Ace6Rings/AUTONOMOUS-UWB-BOT/README.md

# AUTONOMOUS-UWB-BOT
A ground robot with four UWB anchors to determine its location via TDoA or ToF.
