Ace6Rings/AUTONOMOUS-UWB-BOT/JOURNAL.md

---
title: Autobot
author: Ace6Rings
description: placeholder
created_at: "8/2/2026"
---

# 8/7

This session is the first session for wiring the schematic.
I first spent some time researching the exact mcu and uwb chip I'm going to use for the anchors.
In my pitch, i already said that i am going to use the nrf 52840 and a dw3000 family chip. However, I looked for alternatives from the nrf 52840 because I didn’t want to deal with zephyr. I looked around the internet and found out that the nrf52840 have rust support and can deal with math really well.
The second thing is the package. I used the nrf 5340 qfaa before but it was a nightmare since it is impossible to use the inner ring of the chip without vippo. I did some research to pick the package for the nrf. I found out that the qfn package (48 pins) doesn’t support usb and have the high voltage pin shorted to the regular vdd pin, so using a dc dc thingy is impossible. This doesn’t really hurt the functionality but it does hurt power efficiency. But since the nrf is known for its power efficiency, it doesn’t really matter all that much (at least compared to an esp 32).

This research is around 30 minutes since i also skimmed through the datasheets of each alternate chip and compare the pros and cons. Said chip includes stuff like the esp32 c family and lower power stm 32.
Power delivery is very important in sensitive rf applications like this, so i took some extra care to find the best charging ic i can find. I found a really cool ic that just outputs a clean and regulated power.


It is the ic to the right. The BQ24075RGT is a cool power delivery manager that takes in usb power and charges the battery, and then does some cool internal stuff that outputs power. I skimmed through the datasheet and then finally completed the charging ic. It took around 1 hour to do these.
Now i needed to wire up the dw3210 and the nrf 52840 qfaa r7. It took a long time to get the footprints because all the ones i found are buns. 



You can tell how the symbol is really bad. The pins with multiple functions (like analog input, gpio, qspi) and stuff like that aren’t properly labled. They just put the number on there.
I tried to look for other symbols from other sites but they dont have this specific package available. In the end i have to make my own. I will probably change it soon so that when i wire it it will look good.


This is what i had by the end of remaking everything. This, along with finding all the junk, took around 45 minutes.

The dw3210 symbol took a while aswell. It turns out that only qorvo (afaik) have the symbols and i have been looking at the wrong sources the entire time. It looked something like this



I guess this one is a little better but everything is marked as passive so i have to change that soon. It appears that this is meant to replicate the actual footprint, so i guess its fine. Still lazy for not making this optimized for real world usage tho (like vss on the top).


This is what i had in the end. I spent around 45 minutes messing around with the power. I am worried that i will mess something up so i double and triple checked. I ended up using the reference design as of right now. But i will change it if i need to cuz of space constraints and whatnot. 
I took 45 minutes to look at the datasheet to know whats going on with the symbols you see on the left. The top left is just spi stuff but exton wake up and rstn was worth looking into. Exton i dont really know what to do yet since it lowk just pulls high when its doing stuff and pulls low when its not doing stuff. Ig i can link it to some gpio but its prolly useless.
Wake up is just waking up. Rstn is just reset, though i thought i needed pull up resistors but i realized since the nrf will be powered on in conjunction with the dw3210 anyway i might aswell just let the mcu take full control.
The middle left is just gpio stuff. For the netlabels not named as the gpio, i will use it as led indicators. You can see what it does by looking at the name. However, the gpios are hella butt because of this
0.8 mA does absolutely nothing. I guess i will use a cheap mosfet to drive the led ig, but thats if i have the space. Reading the dc characteristics of this took like 15 minutes to do.

Time spent: 4 hours

# 8/8 

I spent 30 minutes on fixing my schematic with my friend who knows how to route. 

I left sbu1 and 2 floating, added correct capacitor values to the charging ic, added correct capacitor values to the dw3210, fixed the rf configuration since 2pf cap not required for r2, fixed led direction, and a bunch of other stuff.

Time spent: 0.5 hours

# 8/9 

I finished the schematic for the anchor. 

The first thing I did was to optimize what pins i am going to use. I specifically made it so that the pins are divided into different functions and also the what side they are on in the physical footprint. I made the spi lines so that they wont have to do as much curves nor travel as long compared to if i just randomly picked it. 
On the left hand side of the schematic, I finished wiring all the decoupling capacitors, filters for the antenna and added LF filtering for the dc dc converter for better power efficiency. I confused reg0 and reg1, which is just the stages of power delivery in the nrf 52840, which made me think that dc dc is not available in this package. But it was, it was actually the LDO that was unavailable. 
I got a friend to double check my work and fixed my mistakes, i missed a capacitor for the antenna filtering and changed some values.



I made some connectors so that i can add additional sensors very easily when i build it in real life. Like a temperature or humidity sensor. There is no embedded sensors in this schematic. 
I will add gnd and 3v3 rails later.

I referenced the datasheet for the maximum values for ppm tolerance , ESR, load capacitance, and all the other specs. Then, i input the values that are valid in digikey and then i settled with these two crystals. One 32mhz one and the other 32.768 khz. They are pretty good, and since lower load capacitance can reduce start up time in the nrf, i got one with 8 pf. I would need to simulate the actual load capacitance since there will be some stray capacitance from the board, so i put in temporary values of 12 pf for each capacitor.

This is what it looked like in the end.

Next, I refined the dw3210/dw3220 part of the schematic. I added a crystal, dw gpios, and a second antenna. I want this project to support pdoa out of the box, so yeah. 

For this crystal, it is the recommended crystal to use according to the manufacturer of the dw3000 chips. So i just used that, same logic with the load capacitors. There is a 1 pf decoup cap for XTO.



This is what it looked like in the end.



I used a dip switch to do analog logic with how i am going to configure each anchor. The first switch will be if pdoa is on or off. If Switch 1 is on, pdoa is enabled, and vice versa.  It is connected to an adc/ain pin of the nrf. I did some research on how the ain pin of the nrf worked. It actually read voltage and had a really high input impedance of 5M, so i needed a 10k pull down resistor to complete the circuit and allow the ain pin to read the voltage. 
The next four switches is to identify the anchor. If pdoa is on, and all other switches are on, the anchor is a master, else, its a slave. Since there are four switches for ID, there is 2^4 amount of possibilities. This allows up to 16 anchors to be placed, which is wayyy more than enough. 


This is what the rest of the schematic look like.



This is the entire schematic.

Time spent: 5 hours
# 8/10
I moved on to the robot mainboard pcb today. First, I did a little bit of research on the general parts im going to use and I didn't really do much there.
The main thing I did today is wiring the power circuit. 
I am using the HUSB238 to negotiate the voltage the USBC will deliver, and I configured it so that it gave 12 volts 3 amps (or 3.5, i forgot).

I also added 22 ohm resistors to account for ringing, but it should probably be fine anyway since its usb 2.0
Then, I moved on to the battery charging IC. I chose the BQ24170RGYR. It is a pretty advanced battery charging ic since it can support up to 3 cells and have all those protections and stuff. But that also means there is alot of stuff to wire up. This took the majority of the session time since the documentation wasn't very good at all.

This is the final circuit (besides the values ofc) and it was pretty tedious to get to this point because of reference schematics like this.

It looks pretty simple after I made the circuit myself but it was a huge mess when I first saw it. 
There are pretty strange values like this

I guess they meant microfarad instead of millifarad since other reference circuits made it micro and it just doesnt make sense to have that big of a capacitor anyway.

Finally, I ended up with this LM5176 buck converter. This one is also pretty advanced since theres alot of protections and modes to change the frequency (ig noise) and stuff. This is useful when i make my own filtering later.
This will take some time because every capacitor value isn't fixed. I have to look at the datasheet and do some math to get the capacitor value i want since it does changes settings like bootup time and protection settings.

Time spent: 4.5 hours

# 8/13 

In this session, I worked on the rest of the power schematic for the main robot board.

I did some research on how to use this buck converter. Theres some features like dithering that I didn't need and some features like ccm that I do need for my usecase. I used the webench calculator to find the recommended values for the capacitors, inductors, and resistors for this ic so that I don't have to do the math. At the end, I ended up with the schematic you see above.
Then, I did some research for the rest of the power rails im going to have.
I decided that I should split the power from the battery (~12v) into 24v via the lm5175, and 5v via the LM2596. I didn't spend nearly as much time as with the other parts of the power schematic compared to this but I did do a little research on the efficiency curves. The lm2596 has around ~90% efficiency at 12 vin and 5 vout at like 1.5a or 2a. This is pretty much fine and its not like I'm powering anything crazy.

Then the 5 volts is going to go to components that need 5v (prolly or prolly not, depending on what stuff I put on there)
and then the 5v is going to go to different low noise ldo to 3v3. The dw3220 are each going to get their own ldo and their own filtering, and i'll make sure anti resonance doesnt happen (prolly won't anyway).


Time spent: 3 hours

# 8/15

Today is mainly figuring out the actual components of the board. As of right now, I'm going to use a stm32H7 series chip (footprint tbd), two bmi 270 so i can get accurate positioning and acceleration data, two dw 3220 for polling, two tmc 2209 la t for the motor drivers, four tof sensor modules (it will just little 2.54mm pins on the actual pcb since im going to use a module), and two rotary encoders.

I didn't get to record the entire session since it paused midway, but hopefully journaling is enough.



I first did the power for the stm32 and the boot pins and reset. I did some research and it turned out that most of the stuff i have to worry about is firmware, so yeah.



I then did some research on the bmi270 and decided to use the spi 4 wire option because it is faster than i2c. I have more than enough pins so it doesn't matter. They will both be in separate buses so that data arrives at the same time and i can average them out and stuff.



I read the datasheet for the tmc2209 and got to this. I had to make the symbol myself since the others were pretty bad.
I configured the tmc2209 so that it gives the stm32 data on the position of the motor via the index pin and also some other diagnostic stuff that i only have to worry about in the firmware. There are probably libraries already so im fine.
The diagnostic pin will give diagnostics ig and pdn uart is just a uart pin. Spread and stdby is marked nc because uart takes over anyway so its fine. MS2 and MS1 are configured in a way that it gives 64 microsteps and its uart id is 2. Usually its a problem if they have the same id but its fine because im using separate uart pins for each, so its all good. 
Now, all i have to do is place down some 2.54mm pins to connect my stuff to my modules. But this is going to be quite difficult on the pcb side since i have to account for the cad at the same time, and i dont even have a design in mind right now. The pcb shape will obviously need to account for the dw3220 antennas (2, or 4) so thats a significant amount of space. The mechanical side is not yet figured out exactly but i will just probably use a nema 14 and a timing belt at a 7.5 gear ratio to get the best torque i can. 
Im also not sure what to do about the power schematic so far since im afraid i will mess something up and the robot is gonna blow up.

Time spent: 2 hours

# 8/16

This session focuses on the digital part of the schematic. Usually I can just slap stuff onto the gpio and be done with it, but I've never used the stm32. 
First, I decided to switch my mcu to the stm32h743zit6 because of its higher clock speed (480 mhz). It does have a lower amount of ram (400kb less) but it should be fine since i won't be using a lidar.
Speaking of lidars, I decided to not use a 2d lidar anymore because the vehicle is going to be low on the ground. There is just no significant advantages to using a lidar over a ToF sensor. 
I chose to use the VL53L1X module from adafruit. I might use their other module with a smaller range in how much distance it measures but can measure shorter distances more accurately. I might just use that because this is meant for obstacle avoiding anyway.
(VL6180X)
Choosing the pins for the stm32 is also a challenge because of the board layout. The board will largely be symmetrical because i need it to be for my bmi 270 and dw3220. It just won't work correctly if it isn't. I did some preliminary wiring.

Oh yeah i changed the nreset wiring because it has an internal pull  up.

I made my own symbol for the adafruit module and it looks like that. I will organize my schematic later fr

After asking on the kicad discord server i decided that i shouldn't use an onboard battery charging module due to safety reasons. It won't improve my performance in anyway so i might aswell omit that and leave it for v2.

I added a ina226 to do some current sensing and added a shunt resistor. I might change the value but 5m seems good rn.

And yeah i changed the mcu to this



This is the entire schematic, i will clean it up later.
Time spent: 2 hours

# 8/19 

This session is about doing a little more research on how the overall project is going to go. First, I decided to look for simpler buck converters to avoid potential issues. I don't want by project to not work just because of some power management issue. However, all the simple buck converters can't provide sufficient power. 
So i decided to go back to the lm5175, mainly because i don't want my previous research and work to go to waste. After some thought, I decided that I should just make the power system on a separate breakout board.
The battery will first go to the breakout board via screw terminals (or whatever port is good, maybe i'll just get a 12v pack but thats chunky and looks unpolished). Then, the power will split to the lm5175 path and the other path will go straight to the 12v terminal. So one board provides both 12v and 24v. This is also optimal for noise because they are physically on separate boards.
I might also put the 5v buck converter here so that the board just outputs 24v and 5v. The 3v3 ldo will be on the mainboard to optimize for noise.

To do this, I first need to confirm my values and parts. So far, I've been slacking a little about part sourcing and values, but this time i need to confirm it.
The lm5175 will be configured for 12v-16v vin (originally 6-16v but 2.6uH inductors are very difficult to source, so 3.3uH is the best option), 24 vout, 10 ms wake up, and ccm on.
Because i changed the settings, the values naturally shift aswell.



You can see how the values changed and also my parts are there too (except for the mosfets, I will deal with them tomorrow).
Then, I moved onto some preliminary pcb routing. It is still unfinished and unpolished, but here is the progress i made.

I decided to use electrolytic capacitors (smd) because the datasheet says that its recommended.

I routed the config pins

The mosfets wont be sot23, so i didnt route this yet. The inductor is huge though.
Here is the overall board. It is going to be long and skinny. Hopefully this will turn out nicely. I doubt that the UWB performance will drop because of the extra wires, infact, it might be better since theres more space in the main board and less noise (hopefully). <br>

Time spent: 4.6 hours

# 8/20

This session is a continuation of making my breakout board for the power. 
Finding parts was quite a challenge because I am unfamiliar with analog and power circuits. I searched up what parts are recommended and i ended up using the reference parts from Webench calculator. Most of the parts are unavailable in jlcpcb pcba service, so i used the part as a reference instead. I finally got all my parts.



These are the parts i found, and of course i needed to source the footprints aswell. 
Overall, these didn't take so long. Maybe 1-1.5 hours worth of part sourcing.
The most challenging part was to find the correct inductor, since the rest of the bom depends on this one inductor. I configured the lm5175 so that it uses a 2.2uH inductor. Some inductors are just too big, and some aren't exactly power inductors. I finally found the correct inductor, and it is pretty space efficient too. 
This does mean i have to drop my max current but thats fine as long as i get nema 17 motors (8A max since 2 A per phase and there are 2 bipolar motors).
As for the capacitors, I've heard that polymer capacitors perform much better because of its ESR and ripple current. I don't know too deep about the capacitors, and power isn't the point of this project anyway. 
You might also notice that the picture of the lm5175 is a different package. That is because the qfn version is unavailable and I had to change the pin definitions. That was a little annoying but its fine. 
Now, for the PCB, I looked around the internet for recommended setups (cuz im not a professional). I tried out multiple orientations, but i find that this one works the best.

This one is pretty cool since all the high power stuff is in copper pours and the gate pins are conveniently placed. very cool. 

This part of the pcb wasn't in the previous picture because i didn't quite figure it out yet. I will probably place the diodes in a far away place since these diodes are just for boot pins.

I placed some vias for the SW1 and SW2 pins (sw2 not done). Hopefully that is enough to carry alot of current. The package of the lm5175 is certainly a challenge, and i am not sure of the effects of placing the hdrv1 trace so close, but it should be fine since it is only 300khz. They are separated by 2 layers anyway, with a gnd plane right underneath as reference. 
Also i might put the bottom stuff into the 3rd layer since that is what they are for anyway, power. 
I also need to figure out what to do with all the empty space, I can't exactly make it thinner or shorter, but functionally it should be ok for my robot. 

Time spent: 4.75 hours

# 8/21

I continued to route my pcb, it's almost done! I conferred with my friends, who also happens to be making a power supply using a buck boost converter, he gave me some tips like using a LTC2433 instead of using a current sense resistor for the average current sense feature. 
I also found some reference schematics at https://www.ti.com/reference-designs/index.html#search?keyword=LM5175 and https://www.ti.com/lit/df/tidrha4/tidrha4.pdf?ts=1787329435707&ref_url=https%3A%2F%2Fti.com%2F
I didn't really get anywhere far in this session since I was more focused on making my existing routing work and i was stressing over the placements of parts and such. I thought that I should place the decoupling capacitors close, but for this specific package it seems to be impossible.

This part of the pcb was what took most of the time today. There is just so much sensitive traces in a such weird order (cuz of the pinout) that it is pretty hard to make this work. Thankfully, I have reference pcbs to help me, but i shouldn't rely on that completely. 
I added this to my sw2 pin, technically i don't have to do this thick of a "trace" but it just looks so much nicer. I did some research on how this ic actually works, and it turns out that none of the pins actually have high current, they just sense stuff and switch the mosfets. 
Speaking of mosfets, this is the routing that i did. Its okay ig.

This is the entire pcb rn. I could just route the rest lazily and move along and it will still work (albeit prolly not well), but i want this to be as polished as it can be. 

Time spent: 2.5 hours

# 8/22 

For this session i finished the breakout board pcb routing and did half of the anchor pcb. 
For the breakout board i did some additional research on how to ground the thing and also the copper planes on the first layer.

To connect pgnd and agnd the datasheet says to connect them in the ic pad, which i did. There was some issues with getting the nets right.

From the two pictures, you can see that there is a small agnd plane and a bigger gnd plane for the rest of the bottom board. They are connected (will be after i get my via stitching plug in) using vias which stitches the 1st layer gnd plane to the 2nd layer gnd plane (unbroken). 

This is the final (not really) look of the pcb. There is definitely some improvements to be made but i want to focus on the real project instead of some power system. 
I planned to continue my mainboard schematic but decided that i should do the anchor pcb first, especially since the schematic is actually well polished and finished (except for some footprints).
I first used user drawings to draw out the shape of the pcb, this is 40mm by 75 mm. I centered everything using some user drawings aswell to make this as symmetrical as i can. This is because of the spi traces you see on the top of the nrf. 

You may also notice some pin header footprints on either side of the board. These are used to flash the chip, debug the chip, and also some extra gpio pins that i may or may not use after i build it (like adding a imu to detect if the anchor has been moved). In any case, these pin headers should be useful to me and also just makes the board much more useful for others to build off of. 
You may also notice that there are rounded traces for my rf trace. This is because im going to run this at ~8ghz but it can be like 7-9. I forgot the exact figures. There is also two dc blocker capacitors (0201) and im going to put a gnd plane on the first layer and stitch it. That way, everything should be ok. 

Time spent: 4.2 hours

# 8/23

For this session i continued working on the anchor pcb. Most of the time was spent trying to figure out how to do the decoupling capacitors for the dw3220. I can tell that i will spend quite some time to do the power system for the nrf52840 aswell. This is because i enabled the dc dc buck converter in the ic, which increases efficiency but adds a few components i need to use. Since i am aiming for having single side pcba, it is pretty difficult to optimize the placement. The crystal was a nuisance since it is big and also have external load capacitors. Conveniently, they are also next to the power pins i'm trying to decouple.

After a few tries, i think it turned out pretty good, i dont think i can optimize this further without changing the parts and footprints. Why not 0201? because that causes pcba to be much more expensive allegedly (didnt test).
I also used rounded corners to minimize reflection and stuff. The cyrstal is especially important, probably the most important component on the board besides the antennas. This is because i need precise clock measurements because of what i am doing with it (you should know from the context of this project).
According to the application notes, it seems to recommend a specific crystal and requests a 3.3 pf load capacitor. I will look more into it tomorrow. Also, there is stuff about band pass filters. I will look into that later aswell since it might be useful/required for the project. This could improve performance i guess.
But anyway, I didnt work on the actual rf portion of the pcb today. I did literally everything else except for the nrf antenna, i might not even use it but i guess i can give it a try (its just inconvenient to route)

So far, its looking good. 
I just need to find the inductors and dipswitch i want and everything will be complete. <br>
Time spent: 2.67 hours

# 8/24

I just added a dipswitch and a tactile switch to my pcb. Then, I added the inductor and capacitors. I will optimize for noise but right now i would like to focus on the actual rf portion of the pcb. I also noticed that the dw3220 is not available on jlcpcb nor digikey, so this could be an expensive project (i alr knew that anyway).
This time there isn't much to say since it really is just grunt work and the majority of the time spent is on part sourcing and footprint finding. 
Also i decided to not have a nrf52840 antenna since it is pretty useless and theres no space for it.

"

Time spent: 1.5 hours

# 8/25

This session focuses on the rf portion of the anchor. There isn't much routing going on today, I mainly did research on how the pcb itself is going to be manufactured and how that is going to affect my rf performance.
Different stackups have different effects on the antenna. I tried my best to follow the application notes for the dw3220, but due to manufacturing costs (some stackups can't be used with economic pcba) i am forced to use the normal/default stack up. I also decided that i want impedance control.

I also changed the material that the pcb is going to be made out of since it gives better performance ig. Its only a few extra dollars

I also chose to use epoxy via finish cuz i need it for via in pad (maybe)

I also did some research on how to route my antenna. This is preliminary since i didnt add my L1 gnd plane yet and the stitching vias are not confirmed yet cuz i need to do some calculations and such.

Time spent: 3 hours

# 8/26

I only did some preliminary research on how to do my pcb.
I made a plan to see what i am going to use for my mainboard, and after that research, things stayed mostly the same. I deleted the power stuff (the lm5175 and the husb238). That would simplify my design by a whole lot. 

I also changed the ms1 and ms2 config cuz it changes the uart address. The microstepping is done digitally instead of using ms1 and ms2 as a way to assign the uart address. I will likely use two buses so it doesnt rlly matter.
Other than that, nothing really happened on the schematic.

Time spent: 1.6 hours

# 8/27 and 8/29

I merged these two dates because it feels right to combine them cuz they basically do the same thingy ig.

I first did some research on esd protection. I will watch some videos on more protection circuits like an e fuse or whatever.
I did a placeholder esd protection thingy for my amt 102 and my usbc data lines (i prolly dont even need this cuz its not that deep).
As you can see, i didnt source all the parts yet cuz no one wants to find ferrite beads.
Then, I changed my lm2596 to the superior lmr51430 cuz its allegedly lower emi. I don't want to do that deep of research on analog/power circuits again. 

Doing the footprints also took a substantial amount of time. But it isnt anything crazy since i already know what components to use, unlike for the breakout board i made.
I didn't put the buck converter on the breakout board because there isn't enough space, and since its supposedly low emi i guess its fine if i put it far far away with some via stitiching. 
I think now is the best to start my pcb 

I did some prelim wiring. I like to do my components independently before slapping on the board because the routing is going to be the same anyway (like passives and stuff). The tmc 2209 shouldn't be hard at all to route. 

There isn't really much to say for this journal since there isn't much research, its all doing stuff i already knew.
But i will be reading alot of the stm32 documentation tomorrow since i want to make sure my stuff actually boots and also what all the pins do before doing more wiring. 

Time spent: 4.5 hours

# 9/2

In this session I worked on the power and boot logic for the stm32. 

I found out that i need a 10k resistor pulling it down instead of having it on the 3v3 side. 
I want my stm32 to boot in as many ways as possible, so i also added a connector thingy that a st-link v2 can directly connect to. 
I looked in my schematic and i found it to be messy and unorganized. So, i made a new schematic.






This took majority of the time.
I also took some time to look at the stm32 datasheet to figure out what pins to use. I only gotten a little bit of work done on the pcb side.


Figuring out what pins to use would be difficult because every single pin are multi function, so i need to choose my pins carefully. Some pins are also superior to others like one pin could have tim channel 1, which is the super accurate timer ig. I also need to make this board symmetrical and stuff.
I used the cubemx thingy to help me find the pins i need.
There isn't really anything else to say cuz its just grunt work atp.
Time spent: 4.75 hours

# 9/3

Today i did some preliminary routing for the motor driver and dw3220. 
I decided not to use two dw3220 since there is no real benefit to me and its also cheaper to just have one. It is also simpler mechanically too.
Routing the tmc2209 and the amt102 is a bit of a challenge because the stm32 has alot of bullshit pins that does alot of different things. 
I decided to use a timer pin for the step (to time it better ig) and use a special timer (tim1-8) for the amt102 because it can calculate whatever the amt102 sends back through hardware instead of me doing it by software (which is better). 



Right now, the board is a bit big, i will optimize for space later on and make it look cooler.
Time spent: 3.6 hours

# 9/4
I did some more research on how my mainboard should be. I decided that i should use a bldc instead of a stepper motor because it is more efficient, smaller, and lighter than a typical stepper motor. 
I didn't decide on the actual motor yet, but i did decide on the esc components.
I will be using the stm32g0 and the mct8316zr. I chose these two components because the stm32g0 is cheap and is more than capable of running the mct8316. Its job is just to tell the mct8316 what to do. It doesnt actually do any of the math. The math and other calculations (from the bmi270, dw3220, the tof sensor) will be done on the h743 because it has a fpu and has a higher clock rate (also more ram).
I chose the mct8316 because everything is integrated, so im not really making my own esc, but ig it is still a motor driver. The esc is not the point of the project so why bother making one myself when its specs are perfectly fine. 

Time spent: 2.52 hours

# 9/13
I decided on using two boards.
I will be using the stm32g0 (48 pin variant) because it is suitable for driving two mct8316zr and also the amt102.
I put the amt102 on the driver board so that it can correct any deviations from the commanded movement. For example,
the stm32h743 will tell the stm32g0 to move 10 meters forward, and then the g0 will generate a pwm signal to drive the motor until it reaches 10 meters. Without the amt, it could guess when it moves 10 meters, but it couldn't know for sure. But with the amt102, the stm32g0 will know for sure (not really but yk) that it did move 10 meters.
if i put it on the main board, then it is kinda bad because the stm32h743 will have to tell the driver board if its there or not. I want the motor movement to be independent after the h743 commands it to do something. 

This is the completed schematic for the driver board. 
The hierarchal sheets aren't done yet (the connectors), but it is just jst and banana plugs with esd protection (maybe), so it doesn't matter for now.
This design follows this logic:
the ToF sensors, bmi270, and the dw3220 will be on the main board. It will get its global coordinate from the dw3220 and get its local coordinate (not really? but yk its local) from the bmi 270 and the amt102 data. 
The mainboard will detect obstacles and its coordinates to determine movement. Once it does the math it will tell the stm32g0 via usart to move somewhere, this shouldn't take alot of bandwidth so thats why im using usart.
This sounds simple but the uwb part (lowk the entire point of the project) would be pretty hard to do, especially if i want to test nlos condiditons and ground that isn't completely flat (3d instead of 2d).

Time spent: 2.8 hours

# 9/14

I "finished" my schematic for my stm32g0 board. 

I moved onto making the pcb (i will add the passive footprints later). Unfortunately, i can't just mix and match the spi buses and i ended up with routing like this.

It took me a while to look for different orientations and ways of routing so that it isnt completely ass.
But other than that there isn't much else to say.

Time spent: 1.1 hours

# 10/3
I switched out the esc ic im going to use. I won't be using hall sensors in my motors, so i decided to go for a sensorless esc, the mct8316a1v. 


As you can see, the schematic is much simpler.

I had to make the symbol and figure out what pins to use, etc. I finished the schematic (well ig, there will be more polishing to do).
There isn't much else to say since this is really just grunt work, but there is lapse so wtv. 

Time spent: 4.25 hours

# 10/4
I finished the preliminary design of the driver board today. I first had to put the net labels onto the stm32 and then switch them around according to the physical footprint of the stm and mct. That didn't take very long and it worked out pretty well.
I tried to make the board smaller cuz smaller is better when i have limited space, and yeah.

I don't have the motor pad yet, but i will add them soon. It shouldn't take very long.
This is the top layer, it looks pretty good to me, but i will polish it towards the end of the project.
This is the bottom layer, theres nothing special. You might think why i used the back side for 5v and 3v3. Thats because if i were to use the 3rd layer, the power plane will be split (not really but like the path will be way longer. I also fixed up some vias so it doesnt cut the gnd plane too.

Time spent: 2.9 hours
# 10/10 

I finished the motor driver board (not polished)


this should functionally work, i made some changes to how i will connect everything.
i made almost everything (digital) jst cuz its easy to connect and impossible to physically connect it wrong. I also added esd protection on the two amt102, added a tvs to the 24v rail, and other stuff.
Im a little worried about the grounding, but it should be fine.




the routing looks okay, it could be better but that would just be more aesthetics than function.

I then ported the anchor pcb design to the mainboard because they use the same uwb chip (obviously) and the routing would be the same. 


Notice how there is no routing for the antenna yet, that is because i need to figure out the physical board config first and put it all in a calculator. I also plan on just using 0402 dc blocker capacitors because its cheaper for pcba. But that may do bad things to the signal, but then its impossible to make everything ideal anyway. 

time spent: 3.25 hours

# 10/11

I did some routing for the bmi270 and some research about the mechanics of the board. I didn't consider that having two imus might be useless if their physical conditions/environment is the same. So i need to think about separating the imus and/or putting little slots in the pcb.
I will also fix the power situation for the driver board later because putting power plane(s)/trace(s) near clock lines is pretty bad. 




The rest of the routing is going to be relatively easy since all the hard stuff is already done (not really). 

time spent: 1.9 hours

# 10/24

I routed the mainboard and changed how the ToF sensors are going to be configured. I will just put them all on one i2c bus, and change their addresses by using the xshut pin and change their addresses one at a time at start up. I also did the buttons, power, change the crystal routing, and some other stuff. 
As for the driver board, i changed the power routing.

The electronics are almost done. The cad should be much quicker since it wouldn't be much different to the other stuff i built.
the coding will be the most interesting part tho.

time spent: 3 hours

# 10/31

More routing. I changed the buck converter to a fixed one, which makes my life easier. There isn't much to say design wise, since this is just boring stuff. 
The routing looks pretty lame (prolly because it is), but it will work pretty well. I will fence the area near the bmi270 though.

Some power routing, I changed the terminal to smth bigger. I also added a switch ic so that it doesnt fry my shit.



Last things to do is wire the tof sensors, impedance match the antennas, and make it polished. Then check over it.

time spent: 2.4 hours
