Ace6Rings/AUTONOMOUS-UWB-BOT/ELECTRONICS/MAINBOARD/autobot_mainboard.kicad_pcb

## KiCad design ELECTRONICS/MAINBOARD/autobot_mainboard.kicad_pcb (2026-11-01)

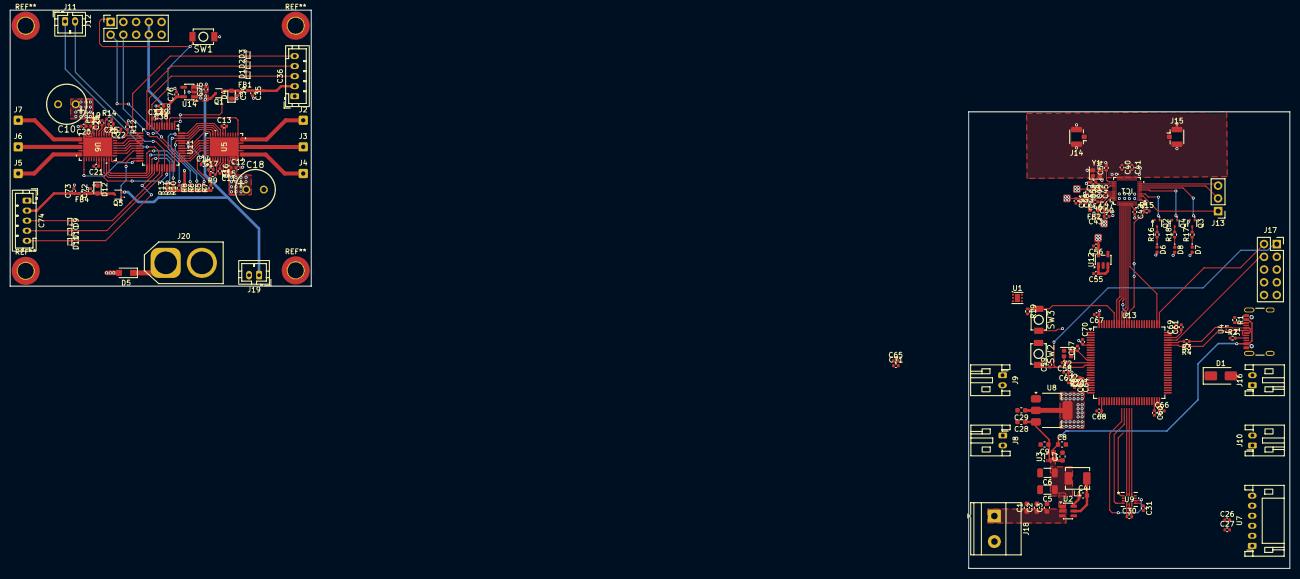
[picture p1: board autobot_mainboard.kicad_pcb from above]

Board: 4 copper layers, 255.0 x 111.2 mm, 156 parts (0 on the bottom side), 122 nets.

Parts:
C1, C28, C29: 10u; C_0603_1608Metric
C2: 1u; C_0603_1608Metric
C3, C4, C7, C8: 100n; C_0603_1608Metric
C5, C6: 22u; C_1206_3216Metric
C9: 4u7; C_0603_1608Metric
C10, C18: 100u; CAP-TH_BD8.0-P3.50-D0.6-FD
C11, C12, C19, C20, C26, C30, C31, C37, C38, C42, C47, C48, C49, C59, C62, C64, C65, C66, C67, C68, C69, C70: 100n; C_0402_1005Metric
C13, C14, C15, C21, C22, C23, C55, C56, C63, C75, C76: 1u; C_0402_1005Metric
C16, C24: 47n; C_0402_1005Metric
C17, C25, C34, C35, C72, C73: C; C_0402_1005Metric
C27, C51, C52: 10u; C_0402_1005Metric
C36, C74: AMT-102-V; JST_PH_B5B-PH-K_1x05_P2.00mm_Vertical
C39, C71: 4u7; C_0402_1005Metric
C40, C41: 2p; C_0402_1005Metric
C43, C44, C45: 4.7n; C_0402_1005Metric
C46: 220n; C_0402_1005Metric
C50: 4.7u; C_0402_1005Metric
C53, C54, C57, C58: 12p; C_0402_1005Metric
C60, C61: 2.2u; C_0402_1005Metric
D1, D2, D3, D9, D10, D11: D_TVS; D_SOD-923
D1#2: SS24; D_SMA
D4, D12: D_TVS; D_0603_1608Metric
D5: PTVS17VZ1USK; Nexperia_CFP3_SOD-123W
D6, D7, D8: LED; LED_0402_1005Metric
FB1, FB3, FB4: FerriteBead_Small; R_0402_1005Metric
FB2: fb; R_0603_1608Metric
IC1: DW3210; qfn_DW3220_QOR-M
J1: USB_C_Receptacle_USB2.0_16P; USB_C_Receptacle_GCT_USB4105-xx-A_16P_TopMnt_Horizontal
J2, J3, J4, J5, J6, J7: Conn_01x01_Socket; SolderWire-0.25sqmm_1x01_D0.65mm_OD1.7mm
J8, J9, J10, J16: Conn_01x02_Pin; JST_PH_S2B-PH-K_1x02_P2.00mm_Horizontal
J11: Conn_01x02_Socket; JST_PH_B2B-PH-K_1x02_P2.00mm_Vertical
J12, J17: Conn_02x05_Odd_Even; PinSocket_2x05_P2.54mm_Vertical
J13: Conn_01x03_Pin; PinHeader_1x03_P2.54mm_Vertical
J14, J15: Conn_Coaxial; U.FL_Hirose_U.FL-R-SMT-1_Vertical
J18: Conn_01x02_Pin; TerminalBlock_Phoenix_MKDS-1,5-2-5.08_1x02_P5.08mm_Horizont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
J19: Conn_01x02_Pin; JST_PH_B2B-PH-K_1x02_P2.00mm_Vertical
J20: Conn_01x02_Pin; AMASS_XT60-F_1x02_P7.20mm_Vertical
L1: 4u7; L_Chilisin_BMRA00040415
Q1, Q2, Q3, Q4, Q5: DMG1012T; SOT-523
R1, R2: 5.1k; R_0402_1005Metric
R3, R4, R9, R14: 22; R_0402_1005Metric
R5, R6, R7, R8, R10, R11, R12, R13: 10K; R_0402_1005Metric
R15: 100K; R_0402_1005Metric
R16, R17, R18: R; R_0402_1005Metric
R19: 10k; R_0402_1005Metric
R20: 47; R_0402_1005Metric_Pad0.72x0.64mm_HandSolder
SW1: SW_Push; SW-SMD_L3.9-W3.0-P4.45
SW2: RESET; SW-SMD_L3.9-W3.0-P4.45
SW3: BOOT; SW-SMD_L3.9-W3.0-P4.45
U1: TVS1400DRV; WSON-6-1EP_2x2mm_P0.65mm_EP1x1.6mm
U2: AP63205WU; TSOT-23-6
U3: TPS2116DRL; SOT-583-8
U4: TPD2EUSB30A; Texas_DRT-3
U5, U6: VQFN40_RGF_TEX_mct8316
U7: VL53L1X; JST_PH_S6B-PH-K_1x06_P2.00mm_Horizontal
U8: NCP1117-3.3_SOT223; SOT-223-3_TabPin2
U9: BMI270; BMI270_BOS-M
U11: STM32G031C_4-6-8_Tx; LQFP-48_7x7mm_P0.5mm
U12, U14: LP5907MFX-3.3; SOT-23-5
U13: STM32H743VITx; LQFP-100_14x14mm_P0.5mm
Y1: TXC 8Y38472012; Crystal_SMD_2016-4Pin_2.0x1.6mm
Y2: 25mhz placeholder; Crystal_SMD_2016-4Pin_2.0x1.6mm

Connections:
+3V3: C26.1, C27.1, C29.1, C38.1, C39.1, C44.1, C45.1, C47.1, C48.1, C49.1, C50.1, C51.1, C52.1, C56.1, C62.1, C65.1, C66.1, C67.1, C68.1, C69.1, C70.1, C71.1, C76.1, D6.2 (A), D7.2 (A), D8.2 (A), FB2.2, FB3.1, IC1.23 (VDD2B), IC1.26 (VDD3), IC1.29 (VDD1), J12.7, J12.8, J17.7, J17.8, R5.1, R6.1, R7.1, R8.1, R10.1, R11.1, R12.1, R13.1, SW3.2, U7.1 (VIN), U8.2 (VO), U11.4 (VBAT), U11.6 (VDD), U12.5 (OUT), U13.6 (VBAT), U13.11 (VDD), U13.27 (VDD), U13.50 (VDD), U13.75 (VDD), U13.100 (VDD), U14.5 (OUT)
+5V: C9.1, C28.1, C30.1, C31.1, C34.1, C55.1, C72.1, C75.1, D4.2 (A2), D12.2 (A2), FB1.1, FB4.1, J19.1, Q1.2 (S), Q1.3 (D), Q5.2 (S), Q5.3 (D), U3.2 (VOUT), U3.7 (VOUT), U8.3 (VI), U9.5 (VDDIO), U9.8 (VDD), U12.1 (IN), U12.3 (EN), U14.1 (IN), U14.3 (EN)
+24V: C10.1, C11.1, C12.1, C15.1, C18.1, C19.1, C20.1, C23.1, D5.1 (K), J20.1, U5.9 (VM), U5.10 (VM), U5.11 (VM), U6.9 (VM), U6.10 (VM), U6.11 (VM)
/AMT102_L/AMT_A: C36.3 (A), D1.1 (A1), U11.11 (PA0)
/AMT102_L/AMT_B: C36.4 (B), D2.1 (A1), U11.12 (PA1)
/AMT102_L/AMT_GATE: Q1.1 (G), U11.1 (PC13)
/AMT102_L/AMT_X: C36.5 (X), D3.1 (A1), U11.13 (PA2)
/AMT102_R/AMT_A: C74.3 (A), D9.1 (A1), U11.30 (PC6)
/AMT102_R/AMT_B: C74.4 (B), D10.1 (A1), U11.31 (PC7)
/AMT102_R/AMT_GATE: Q5.1 (G), U11.23 (PB11)
/AMT102_R/AMT_X: C74.5 (X), D11.1 (A1), U11.28 (PA8)
/BMI270_L/BMI_CS: U9.12 (CSB), U13.41 (PE11)
/BMI270_L/BMI_MISO: U9.1 (SDO), U13.43 (PE13)
/BMI270_L/BMI_MOSI: U9.14 (SDX), U13.44 (PE14)
/BMI270_L/BMI_SCK: U9.13 (SCX), U13.42 (PE12)
/DW3220_T/CSN: IC1.37 (SPICSN), U13.77 (PA15)
/DW3220_T/DW_GPIO0: IC1.3 (GPIO0/_RXOKLED), J13.1
/DW3220_T/DW_GPIO4: IC1.8 (GPIO4/_EXTPA), J13.2
/DW3220_T/DW_GPIO7: IC1.9 (GPIO7/_SYNC), J13.3
/DW3220_T/DW_RF1: C40.1, J14.1 (In)
/DW3220_T/DW_RF2: C41.1, J15.1 (In)
/DW3220_T/IRQ: IC1.1 (IRQ/_GPIO8), R15.1, U13.88 (PD7)
/DW3220_T/MISO: IC1.36 (SPICDO_(SPIMISO)), U13.90 (PB4)
/DW3220_T/MOSI: IC1.35 (SPICDI_(SPIMOSI)), U13.91 (PB5)
/DW3220_T/RESET: IC1.33 (RSTN), U13.92 (PB6)
/DW3220_T/RXLED: IC1.6 (GPIO2_/_RXLED), Q4.1 (G)
/DW3220_T/RX_OK_LED: IC1.4 (GPIO1/_SFDLED), Q2.1 (G)
/DW3220_T/SPICLK: IC1.34 (SPICLK), U13.89 (PB3)
/DW3220_T/TXLED: IC1.7 (GPIO3_/_TXLED), Q3.1 (G)
/DW3220_T/WAKEUP: IC1.32 (WAKEUP), U13.93 (PB7)
/DW3220_T/XTI: C54.1, IC1.21 (XTI), Y1.3
/DW3220_T/XTO: C53.1, IC1.22 (XTO), Y1.1
/POWER_CONNECTOR/12V: C1.1, C2.1, C3.1, J18.1, U1.4 (IN), U1.5 (IN), U1.6 (IN), U2.2 (EN), U2.3 (IN)
/POWER_MAINBOARD/BUCK_5V: C5.1, C6.1, C7.1, L1.2, U2.1 (FB), U3.3 (VIN1), U3.4 (PR1), U3.5 (MODE)
/POWER_MAINBOARD/VBUS: C8.1, J1.A4 (VBUS), J1.A9 (VBUS), J1.B4 (VBUS), J1.B9 (VBUS), U3.6 (VIN2)
/STM32G0/BRAKE: U5.35 (BRAKE), U11.40 (PD2)
/STM32G0/BRAKE_R: U6.35 (BRAKE), U11.18 (PA7)
/STM32G0/DACOUT1: U5.37 (DACOUT1), U11.38 (PD0)
/STM32G0/DACOUT1_R: U6.37 (DACOUT1), U11.16 (PA5)
/STM32G0/DACOUT2: U5.38 (DACOUT2), U11.37 (PA15)
/STM32G0/DACOUT2_R: U6.38 (DACOUT2), U11.15 (PA4)
/STM32G0/DACOUT2/SOX: U5.36 (DACOUT2/SOX), U11.39 (PD1)
/STM32G0/DACOUT2/SOX_R: U6.36 (DACOUT2/SOX), U11.17 (PA6)
/STM32G0/DIR: U5.34 (DIR), U11.41 (PD3)
/STM32G0/DIR_R: U6.34 (DIR), U11.19 (PB0)
/STM32G0/DRVOFF: U5.21 (DRVOFF), U11.3 (PC15)
/STM32G0/DRVOFF_R: U6.21 (DRVOFF), U11.24 (PB12)
/STM32G0/EXT_WD: U5.32 (EXT_WD), U11.42 (PB3)
/STM32G0/EXT_WD_R: U6.32 (EXT_WD), U11.20 (PB1)
/STM32G0/FG: R8.2, U5.29 (FG), U11.47 (PB8)
/STM32G0/FG_R: R13.2, U6.29 (FG), U11.27 (PB15)
/STM32G0/PWM: U5.28 (SPEED/WAKE), U11.48 (PB9)
/STM32G0/PWM_R: U6.28 (SPEED/WAKE), U11.33 (PA9/PA11)
/STM32G0/SCL: R5.2, U5.31 (SCL), U11.45 (PB6)
/STM32G0/SCL_R: R10.2, U6.31 (SCL), U11.25 (PB13)
/STM32G0/SDA: R6.2, U5.30 (SDA), U11.46 (PB7)
/STM32G0/SDA_R: R11.2, U6.30 (SDA), U11.26 (PB14)
/STM32G0/SWCLK: J12.2, U11.36 (PA14)
/STM32G0/SWDIO: J12.4, U11.35 (PA13)
/STM32G0/USART_RX: J11.2, J16.1, U11.32 (NC/PA10), U13.53 (PB14)
/STM32G0/USART_TX: J11.1, J16.2, U11.29 (NC/PA9), U13.54 (PB15)
/STM32G0/nFAULT: R7.2, U5.40 (nFAULT), U11.44 (PB5)
/STM32G0/nFAULT_R: R12.2, U6.40 (nFAULT), U11.14 (PA3)
/STM32G0/nRESET: C37.1, J12.1, SW1.2, U11.10 (PF2)
/STM32H743/BOOT0: R19.1, SW3.1, U13.94 (BOOT0)
/STM32H743/D+: R3.2, U13.71 (PA12)
/STM32H743/D-: R4.2, U13.70 (PA11)
/STM32H743/NRST: C59.1, J17.1, SW2.2, U13.14 (NRST)
/STM32H743/PH0: C57.1, U13.12 (PH0), Y2.1
/STM32H743/PH1: C58.1, U13.13 (PH1), Y2.3
/STM32H743/SWCLK: J17.2, U13.76 (PA14)
/STM32H743/SWDIO: J17.4, U13.72 (PA13)
/STM32H743/VREF: R20.1, U13.20 (VREF+)
/USB/DATA +: J1.A6 (D+), J1.B6 (D+), R3.1, U4.2 (D-)
/USB/DATA -: J1.A7 (D-), J1.B7 (D-), R4.1, U4.1 (D+)
GNDREF: C1.2, C2.2, C3.2, C5.2, C6.2, C7.2, C8.2, C9.2, C10.2, C11.2, C12.2, C18.2, C19.2, C20.2, C26.2, C27.2, C28.2, C29.2, C30.2, C31.2, C34.2, C35.2, C36.1 (GND), C37.2, C38.2, C39.2, C42.2, C43.2, C44.2, C45.2, C46.2, C47.2, C48.2, C49.2, C50.2, C51.2, C52.2, C53.2, C54.2, C55.2, C56.2, C57.2, C58.2, C59.2, C60.2, C61.2, C62.2, C63.2, C64.2, C65.2, C66.2, C67.2, C68.2, C69.2, C70.2, C71.2, C72.2, C73.2, C74.1 (GND), C75.2, C76.2, D1.2 (A2), D2.2 (A2), D3.2 (A2), D4.1 (A1), D5.2 (A), D9.2 (A2), D10.2 (A2), D11.2 (A2), D12.1 (A1), IC1.2 (GPIO6_/_EXTRXE_/_SPIPHA), IC1.5 (GPIO5_/_EXTTXE_/_SPIPOL), IC1.10 (GND_1), IC1.11 (GND_2), IC1.12 (GND_3), IC1.14 (GND_4), IC1.15 (GND_5), IC1.16 (GND_6), IC1.17 (GND_7), IC1.19 (GND_8), IC1.20 (GND_9), IC1.24 (VSS2), IC1.25 (VSS3), IC1.30 (VSS1), IC1.39 (VSS), IC1.40 (VSS), J1.A1 (GND), J1.A12 (GND), J1.B1 (GND), J1.B12 (GND), J1.SH (SHIELD), J12.5, J12.6, J14.2 (Ext), J15.2 (Ext), J17.5, J17.6, J18.2, J19.2, J20.2, Q2.2 (S), Q3.2 (S), Q4.2 (S), R1.1, R2.1, R15.2, R19.2, SW1.1, SW2.1, U1.1 (GND), U1.2 (GND), U1.3 (GND), U1.7 (GND), U2.4 (GND), U3.1 (GND), U4.3 (GND), U5.12 (PGND), U5.15 (PGND), U5.18 (PGND), U5.33 (EXT_CLK), U5.41 (GNDPAD), U6.12 (PGND), U6.15 (PGND), U6.18 (PGND), U6.33 (EXT_CLK), U6.41 (GNDPAD), U7.2 (GND), U8.1 (GND), U9.6 (GNDIO), U9.7 (GND), U11.7 (VSS), U12.2 (GND), U13.10 (VSS), U13.19 (VSSA), U13.26 (VSS), U13.49 (VSS), U13.74 (VSS), U13.99 (VSS), U14.2 (GND), Y1.2 (G), Y1.4 (G), Y2.2 (G), Y2.4 (G)
unnamed: C35.1, C36.2 (VIN), FB1.2
unnamed: C60.1, U13.48 (VCAP)
unnamed: C61.1, U13.73 (VCAP)
unnamed: C73.1, C74.2 (VIN), FB4.2
unnamed: D6.1 (K), R16.1
unnamed: D7.1 (K), R17.1
unnamed: D8.1 (K), R18.1
unnamed: C40.2, IC1.18 (RF1)
unnamed: C41.2, IC1.13 (RF2)
unnamed: C43.1, FB2.1, IC1.28 (VDD2A)
unnamed: C42.1, IC1.38 (VIO_D)
unnamed: C46.1, IC1.27 (VTX_D)
unnamed: J1.A5 (CC1), R2.2
unnamed: J1.B5 (CC2), R1.2
unnamed: J2.1 (Pin_1_1), U5.19 (OUTC), U5.20 (OUTC)
unnamed: J3.1 (Pin_1_1), U5.16 (OUTB), U5.17 (OUTB)
unnamed: J4.1 (Pin_1_1), U5.13 (OUTA), U5.14 (OUTA)
unnamed: J5.1 (Pin_1_1), U6.19 (OUTC), U6.20 (OUTC)
unnamed: J6.1 (Pin_1_1), U6.16 (OUTB), U6.17 (OUTB)
unnamed: J7.1 (Pin_1_1), U6.13 (OUTA), U6.14 (OUTA)
unnamed: Q2.3 (D), R16.2
unnamed: Q3.3 (D), R17.2
unnamed: Q4.3 (D), R18.2
unnamed: C4.1, U2.6 (BST)
unnamed: C4.2, L1.1, U2.5 (SW)
unnamed: C13.2, U5.26 (AGND)
unnamed: C13.1, U5.27 (AVDD)
unnamed: C15.2, U5.8 (CP)
unnamed: C16.2, U5.7 (CPH)
unnamed: C16.1, U5.6 (CPL)
unnamed: C14.2, U5.2 (DGND)
unnamed: C14.1, U5.1 (DVDD)
unnamed: C17.1, R9.2, U5.3 (FB_BK)
unnamed: C17.2, U5.4 (GND_BK)
unnamed: R9.1, U5.5 (SW_BK)
unnamed: C21.2, U6.26 (AGND)
unnamed: C21.1, U6.27 (AVDD)
unnamed: C23.2, U6.8 (CP)
unnamed: C24.2, U6.7 (CPH)
unnamed: C24.1, U6.6 (CPL)
unnamed: C22.2, U6.2 (DGND)
unnamed: C22.1, U6.1 (DVDD)
unnamed: C25.1, R14.2, U6.3 (FB_BK)
unnamed: C25.2, U6.4 (GND_BK)
unnamed: R14.1, U6.5 (SW_BK)
unnamed: C63.1, C64.1, FB3.2, R20.2, U13.21 (VDDA)
