Ace6Rings/AUTONOMOUS-UWB-BOT/ELECTRONICS/Anchor_stable/Anchor.kicad_pcb

## KiCad design ELECTRONICS/Anchor_stable/Anchor.kicad_pcb (2026-10-24)

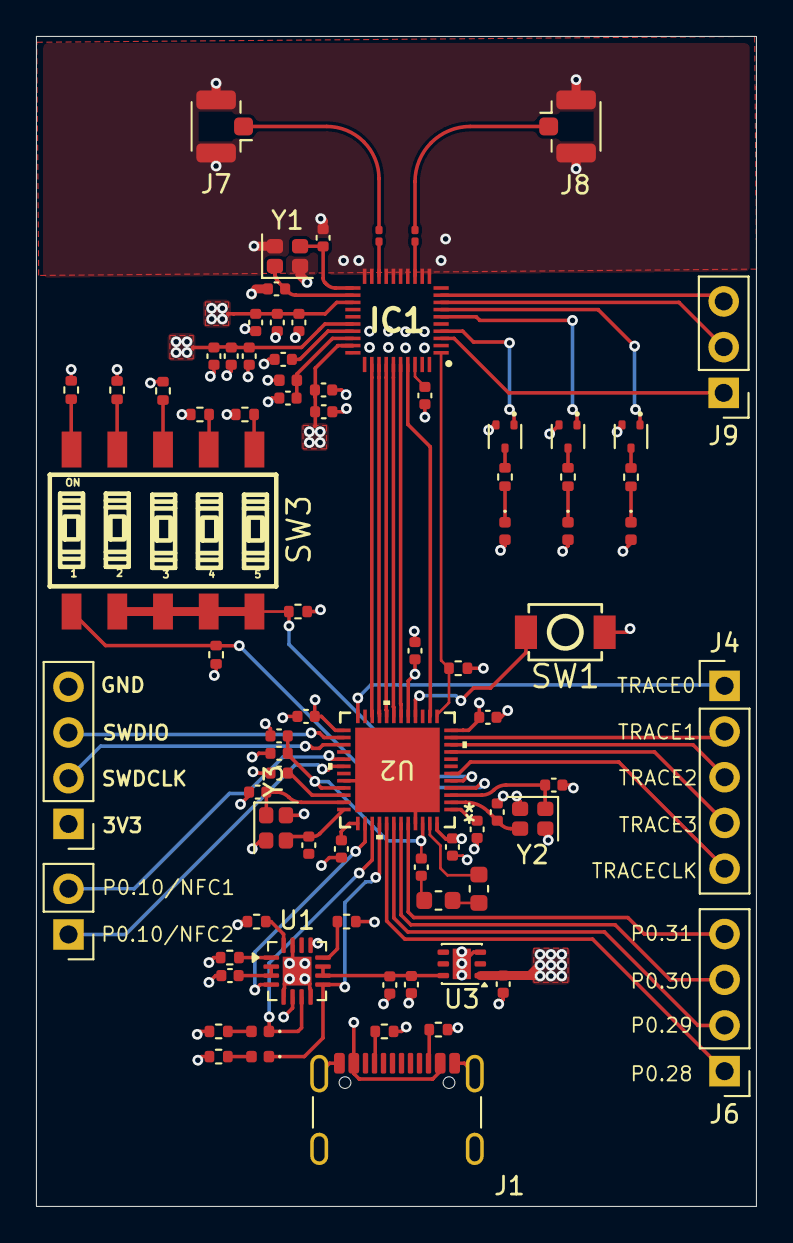
[picture p2: board Anchor.kicad_pcb from above]

Board: 4 copper layers, 40.0 x 65.0 mm, 79 parts (0 on the bottom side), 74 nets.

Parts:
C1, C3, C17: 4.7u; C_0402_1005Metric
C2, C6, C9, C12, C19, C32, C33, C34, C35: 100n; C_0402_1005Metric
C4, C5, C8: 4.7n; C_0402_1005Metric
C7, C10: 10u; C_0402_1005Metric
C11: 220n; C_0402_1005Metric
C13, C31: 2p; C_0201_0603Metric
C15, C16, C23, C36: 1u; C_0402_1005Metric
C18: 47n; C_0402_1005Metric
C20: 100p; C_0402_1005Metric
C21: NC; C_0402_1005Metric
C25, C26, C27, C28, C29, C30: 12p; C_0402_1005Metric
D1, D2, D3, D4, D5: LED; LED_0402_1005Metric
FB1: fb; L_0402_1005Metric
IC1: DW3210; QFN40P500X500X80-40N-D
J1: USB_C_Receptacle_USB2.0_16P; USB_C_Receptacle_GCT_USB4105-xx-A_16P_TopMnt_Horizontal
J3, J6: Conn_01x04_Pin; PinHeader_1x04_P2.54mm_Vertical
J4: Conn_01x05_Pin; PinHeader_1x05_P2.54mm_Vertical
J5: Conn_01x02_Pin; PinHeader_1x02_P2.54mm_Vertical
J7, J8: Conn_Coaxial; U.FL_Hirose_U.FL-R-SMT-1_Vertical
J9: Conn_01x03_Pin; PinHeader_1x03_P2.54mm_Vertical
L3: 10u; L_0603_1608Metric
L4: 15u; L_0603_1608Metric
Q1, Q2, Q3: DMG1012T; SOT-523
R1, R2, R16: 5.1k; R_0402_1005Metric
R3, R4: 2.2K; R_0402_1005Metric
R5, R13, R17, R18, R19: 10k; R_0402_1005Metric
R6, R7, R9, R11, R12: R; R_0402_1005Metric
R10: 100K; R_0402_1005Metric
R14: 1k; R_0402_1005Metric
R15: 2.2k; R_0402_1005Metric
SW1: reset; SW-SMD_L3.9-W3.0-P4.45
SW3: SW_DIP_x05; SW-SMD_2.54-5P-TPGT
U1: BQ24075RGT; VQFN-16-1EP_3x3mm_P0.5mm_EP1.6x1.6mm
U2: NRF52840-QFAA-R7; QFN48_NRF52840-QFAA-R7_NOR
U3: AP7370-33FDC; DFN-6-1EP_2x2mm_P0.65mm_EP1.01x1.7mm
Y1: TXC 8Y38472012; Crystal_SMD_2016-4Pin_2.0x1.6mm
Y2: ECS-320-8-37B-CKY-TR; Crystal_SMD_2016-4Pin_2.0x1.6mm
Y3: ECS-.327-6-1210B-N-TR; Crystal_SMD_2016-4Pin_2.0x1.6mm

Connections:
+3V3: C2.1, C3.1, C5.1, C6.1, C7.1, C8.1, C9.1, C10.1, C16.1, C32.1, C33.1, C34.1, C35.1, C36.1, D3.2 (A), D4.2 (A), D5.2 (A), FB1.2, IC1.23 (VDD2B), IC1.26 (VDD3), IC1.29 (VDD1), J3.1, R6.2, R7.2, R13.2, R14.2, R15.2, R16.2, R17.2, U2.12 (VDD), U2.17 (VDD), U2.25 (VDD), U2.37 (VDD), U2.48 (VDD), U3.1 (VO)
/BAT+: C1.1, U1.2 (BAT), U1.3 (BAT)
/BQ_OUT: C15.1, C17.1, U1.10 (OUT), U1.11 (OUT), U3.6 (VI)
/CE: U1.4 (~CE), U2.38 (P1.15)
/CHG: D2.1 (K), U1.9 (~CHG), U2.40 (P0.02/AIN0)
/DW_GPIO0: IC1.3 (GPIO0/_RXOKLED), J9.1
/DW_GPIO4: IC1.8 (GPIO4/_EXTPA), J9.2
/DW_GPIO7: IC1.9 (GPIO7/_SYNC), J9.3
/DW_RF1: C13.1, J7.1 (In)
/DW_RF2: C31.1, J8.1 (In)
/DW_RST: IC1.33 (RSTN), U2.21 (P0.22/QSPI)
/ID_SEL: R18.2, SW3.2, SW3.3, SW3.4, SW3.5, U2.5 (P0.05/AIN3)
/IRQ: IC1.1 (IRQ/_GPIO8), R10.1, U2.13 (P0.13)
/MODE_SEL: R19.2, SW3.1, U2.4 (P0.04/AIN2)
/P0.09/NFC1: J5.2, U2.29 (P0.09/NFC1)
/P0.10/NFC2: J5.1, U2.30 (P0.10/NFC2)
/P0.28/AIN4: J6.1, U2.41 (P0.28/AIN4)
/P0.29/AIN5: J6.2, U2.42 (P0.29/AIN5)
/P0.30/AIN6: J6.3, U2.43 (P0.30/AIN6)
/P0.31/AIN7: J6.4, U2.44 (P0.31/AIN7)
/PGOOD: D1.1 (K), U1.7 (~PGOOD), U2.39 (P0.03/AIN1)
/RXLED: IC1.6 (GPIO2_/_RXLED), Q2.1 (G)
/RX_OK_LED: IC1.4 (GPIO1/_SFDLED), Q1.1 (G)
/SPICLK: IC1.34 (SPICLK), U2.18 (P0.19/QSPI/SCK)
/SPICSN: IC1.37 (SPICSN), U2.14 (P0.14)
/SPIMISO: IC1.36 (SPICDO_(SPIMISO)), U2.20 (P0.21/QSPI)
/SPIMOSI: IC1.35 (SPICDI_(SPIMOSI)), U2.19 (P0.20)
/SWDCLK: J3.2, U2.27 (SWDCLK)
/SWDIO: J3.3, U2.26 (SWDIO)
/TRACECLK: J4.5, U2.6 (P0.07/TRACECLK)
/TRACEDATA0: J4.1, U2.24 (P1.00/TRACEDATA0/QSPI)
/TRACEDATA1: J4.2, U2.11 (P0.11/TRACEDATA1)
/TRACEDATA2: J4.3, U2.10 (P0.11/TRACEDATA2)
/TRACEDATA3: J4.4, U2.9 (P1.09/TRACEDATA3)
/TXLED: IC1.7 (GPIO3_/_TXLED), Q3.1 (G)
/WAKEUP: IC1.32 (WAKEUP), U2.22 (P0.23/QSPI)
/XC1: C29.1, U2.35 (XC1), Y3.1
/XC2: C30.1, U2.36 (XC2), Y3.3
/XL1: C27.1, U2.3 (P0.01/XL2), Y2.1
/XL2: C28.1, U2.2 (P0.00/XL1), Y2.3
/XTI: C26.1, IC1.21 (XTI), Y1.3
/XTO: C25.1, IC1.22 (XTO), Y1.1
GNDREF: C1.2, C2.2, C3.2, C4.2, C5.2, C6.2, C7.2, C8.2, C9.2, C10.2, C11.2, C12.2, C15.2, C16.2, C17.2, C18.2, C19.2, C20.2, C21.2, C25.2, C26.2, C27.2, C28.2, C29.2, C30.2, C32.2, C33.2, C34.2, C35.2, C36.2, IC1.2 (GPIO6_/_EXTRXE_/_SPIPHA), IC1.5 (GPIO5_/_EXTTXE_/_SPIPOL), IC1.10 (GND_1), IC1.11 (GND_2), IC1.12 (GND_3), IC1.14 (GND_4), IC1.15 (GND_5), IC1.16 (GND_6), IC1.17 (GND_7), IC1.19 (GND_8), IC1.20 (GND_9), IC1.24 (VSS2), IC1.25 (VSS3), IC1.30 (VSS1), IC1.39 (VSS), IC1.40 (VSS), J1.A1 (GND), J1.A12 (GND), J1.B1 (GND), J1.B12 (GND), J1.SH (SHIELD), J3.4, J7.2 (Ext), J8.2 (Ext), Q1.2 (S), Q2.2 (S), Q3.2 (S), R1.2, R2.2, R3.2, R4.2, R5.2, R10.2, R18.1, R19.1, SW1.1, U1.5 (EN2), U1.8 (VSS), U1.15 (SYSOFF), U1.17 (VSS), U2.32 (VSS_PA), U2.45 (VSS), U2.49 (VSS), U3.3 (GND), U3.7 (GND), Y1.2 (G), Y1.4 (G), Y2.2 (G), Y2.4 (G), Y3.2 (G), Y3.4 (G)
unnamed: C23.1, L4.1
unnamed: D1.2 (A), R6.1
unnamed: D2.2 (A), R7.1
unnamed: D3.1 (K), R9.1
unnamed: D4.1 (K), R11.1
unnamed: D5.1 (K), R12.1
unnamed: C13.2, IC1.18 (RF1)
unnamed: C31.2, IC1.13 (RF2)
unnamed: C4.1, FB1.1, IC1.28 (VDD2A)
unnamed: C12.1, IC1.38 (VIO_D)
unnamed: C11.1, IC1.27 (VTX_D)
unnamed: J1.A5 (CC1), R2.1
unnamed: J1.B5 (CC2), R1.1
unnamed: L3.1, L4.2
unnamed: Q1.3 (D), R9.2
unnamed: Q2.3 (D), R11.2
unnamed: Q3.3 (D), R12.2
unnamed: R13.1, SW3.10
unnamed: R14.1, SW3.9
unnamed: R15.1, SW3.8
unnamed: R16.1, SW3.7
unnamed: R17.1, SW3.6
unnamed: R3.1, U1.12 (ILIM)
unnamed: R4.1, U1.16 (ISET)
unnamed: R5.1, U1.1 (TS)
unnamed: L3.2, U2.47 (DCC)
unnamed: C19.1, U2.1 (DEC1)
unnamed: C20.1, U2.34 (DEC3)
unnamed: C18.1, C21.1, C23.2, U2.33 (DEC6), U2.46 (DEC4)
unnamed: SW1.2, U2.16 (P0.18/RESET/QSPI/CSN)
VBUS: J1.A4 (VBUS), J1.A9 (VBUS), J1.B4 (VBUS), J1.B9 (VBUS), U1.6 (EN1), U1.13 (IN)
