Ace6Rings/AUTONOMOUS-UWB-BOT/BREAKOUT_BOARDS/Boostconverter.kicad_pcb

## KiCad design BREAKOUT_BOARDS/Boostconverter.kicad_pcb (2026-08-22)

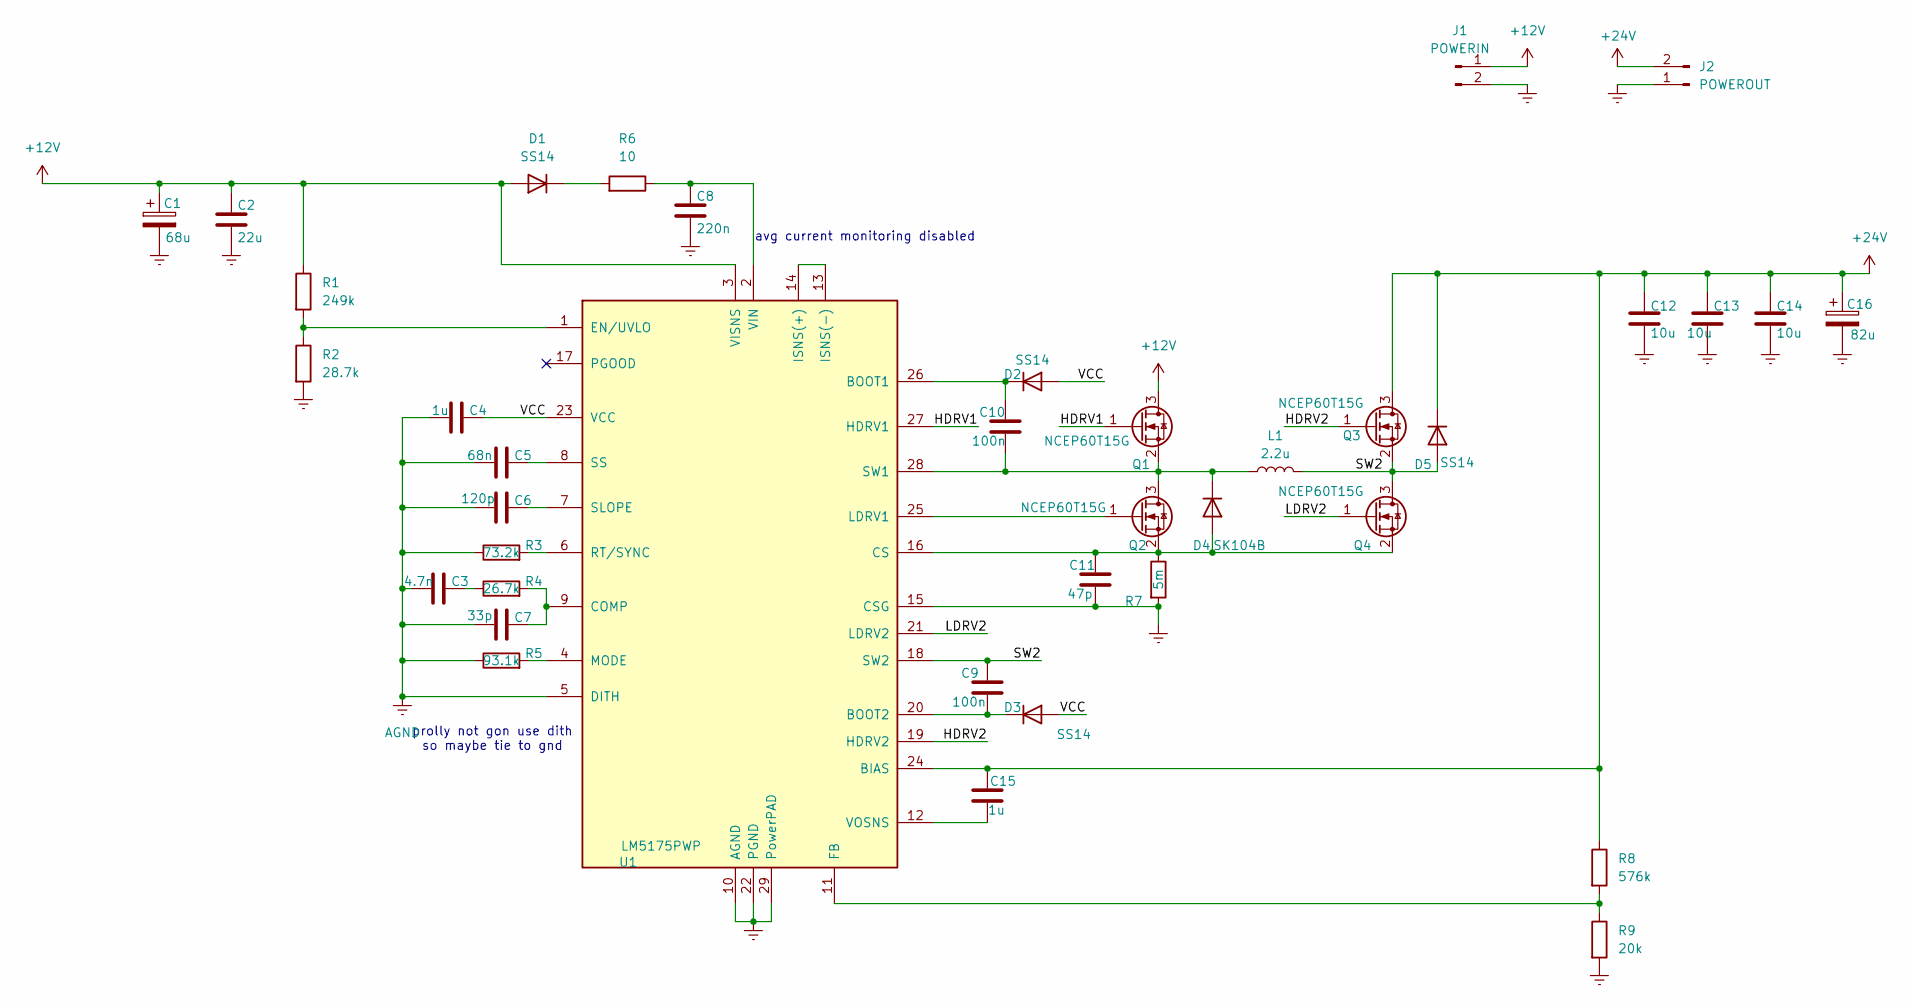
[picture p3: schematic Boostconverter.kicad_sch]

Parts:
C1: 68u; PCAP_SVP_F12_PAN-M
C2: 22u; C_1210_3225Metric
C3: 4.7n; C_0603_1608Metric
C4, C15: 1u; C_0603_1608Metric
C5: 68n; C_0603_1608Metric
C6: 120p; C_0603_1608Metric
C7: 33p; C_0402_1005Metric
C8: 220n; C_0603_1608Metric
C9, C10: 100n; C_0603_1608Metric
C11: 47p; C_0402_1005Metric
C12, C13, C14: 10u; C_1210_3225Metric
C16: 82u; CAP_35SVPF82M
D1, D2, D3, D5: SS14; D_SMA
D4: SK104B; D_SMB
J1: POWERIN; TerminalBlock_Phoenix_MKDS-1,5-2-5.08_1x02_P5.08mm_Horizont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
J2: POWEROUT; TerminalBlock_Phoenix_MKDS-1,5-2-5.08_1x02_P5.08mm_Horizont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
L1: 2.2u; L_Coilcraft_XAL1010-XXX
Q1, Q2, Q3, Q4: NCEP60T15G; AO_DFN-8-1EP_5.55x5.2mm_P1.27mm_EP4.12x4.6mm
R1: 249k; R_0603_1608Metric
R2: 28.7k; R_0603_1608Metric
R3: 73.2k; R_0603_1608Metric
R4: 26.7k; R_0603_1608Metric
R5: 93.1k; R_0603_1608Metric
R6: 10; R_0603_1608Metric
R7: 5m; R_1206_3216Metric
R8: 576k; R_0603_1608Metric
R9: 20k; R_0603_1608Metric
U1: LM5175PWP; VQFN-28-1EP_4x5mm_P0.5mm_EP2.55x3.55mm

Connections:
+12V: C1.1, C2.1, D1.2 (A), J1.1, Q1.3 (D), R1.1, U1.3 (VISNS)
+24V: C12.1, C13.1, C14.1, C15.1, C16.1, D5.1 (K), J2.2, Q3.3 (D), R8.1, U1.24 (BIAS)
/HDRV1: Q1.1 (G), U1.27 (HDRV1)
/HDRV2: Q3.1 (G), U1.19 (HDRV2)
/LDRV2: Q4.1 (G), U1.21 (LDRV2)
/SW2: C9.1, D5.2 (A), L1.2, Q3.2 (S), Q4.3 (D), U1.18 (SW2)
/VCC: C4.2, D2.2 (A), D3.2 (A), U1.23 (VCC)
AGND: C3.1, C4.1, C5.1, C6.1, C7.1, R3.1, R5.1, U1.5 (DITH)
GNDREF: C1.2, C2.2, C8.2, C11.2, C12.2, C13.2, C14.2, C16.2, J1.2, J2.1, R2.2, R7.2, R9.2, U1.10 (AGND), U1.15 (CSG), U1.22 (PGND), U1.29 (PowerPAD)
unnamed: C3.2, R4.1
unnamed: D1.1 (K), R6.2
unnamed: C10.1, D2.1 (K), U1.26 (BOOT1)
unnamed: C9.2, D3.1 (K), U1.20 (BOOT2)
unnamed: C11.1, D4.2 (A), Q2.2 (S), Q4.2 (S), R7.1, U1.16 (CS)
unnamed: C10.2, D4.1 (K), L1.1, Q1.2 (S), Q2.3 (D), U1.28 (SW1)
unnamed: Q2.1 (G), U1.25 (LDRV1)
unnamed: C7.2, R4.2, U1.9 (COMP)
unnamed: R1.2, R2.1, U1.1 (EN/UVLO)
unnamed: R8.2, R9.1, U1.11 (FB)
unnamed: U1.13 (ISNS(-)), U1.14 (ISNS(+))
unnamed: R5.2, U1.4 (MODE)
unnamed: R3.2, U1.6 (RT/SYNC)
unnamed: C6.2, U1.7 (SLOPE)
unnamed: C5.2, U1.8 (SS)
unnamed: C8.1, R6.1, U1.2 (VIN)
unnamed: C15.2, U1.12 (VOSNS)

Notes on the sheet:
prolly not gon use dith so maybe tie to gnd
avg current monitoring disabled

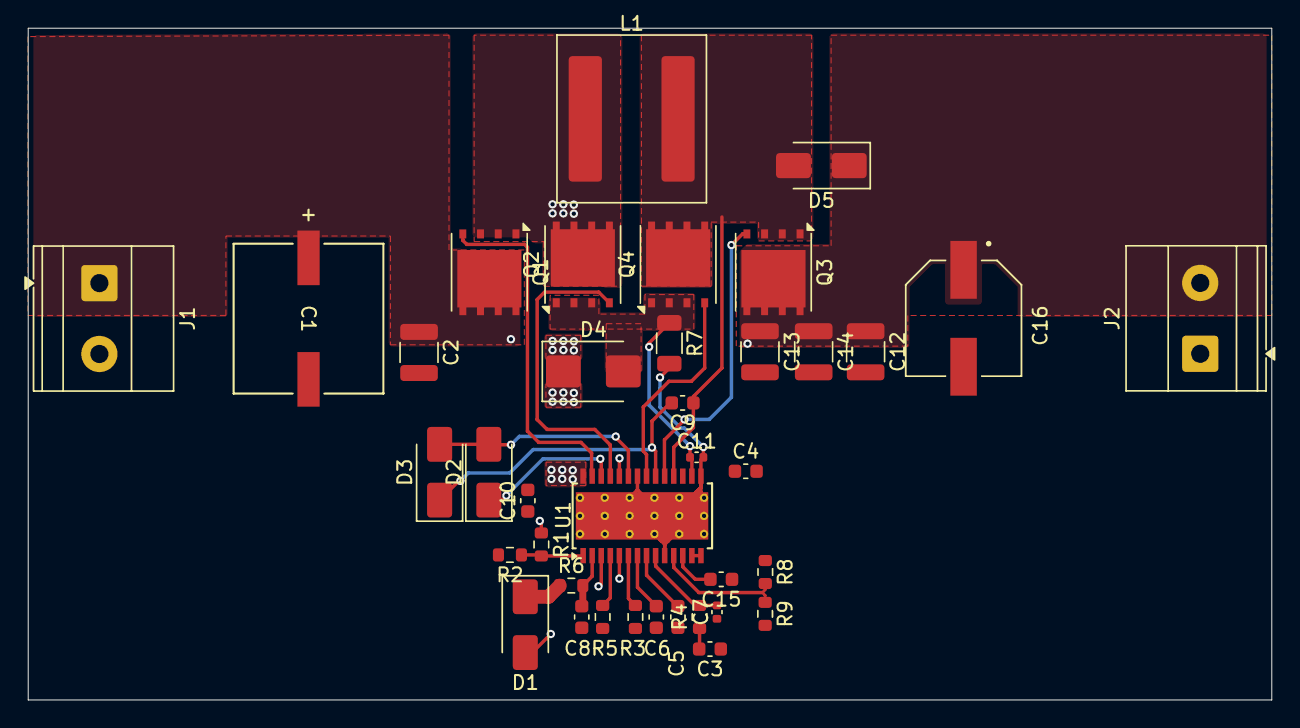
[picture p4: board Boostconverter.kicad_pcb from above]

Board: 4 copper layers, 89.2 x 48.2 mm, 38 parts (0 on the bottom side), 26 nets.
