Ace6Rings/AUTONOMOUS-UWB-BOT/(commit log)

2026-08-08 Finished DW3210 and power wiring for the anchor
    [AutoBot.kicad_pcb, AutoBot.kicad_sch]
2026-08-08 updated prelim journal
    Documented the first session of wiring the schematic, including research on MCU and UWB chip alternatives, power delivery IC selection, and symbol creation for components. Summarized time spent on each task and challenges faced during the design process.
    (copilot slop btw)
2026-08-09 Finalize anchor schematic with optimizations and features
    Completed the schematic for the anchor, optimizing pin usage and wiring decoupling capacitors. Added connectors for additional sensors, refined the dw3210/dw3220 part, and implemented a dip switch for anchor identification.
2026-08-11 Document power circuit and battery IC wiring process
2026-08-15 Update JOURNAL.md with power schematic details
    Documented work on power schematic for the main robot board, including research on buck converter usage and power rail distribution.
2026-08-15 Update JOURNAL.md with component and power details
    Documented progress on component selection and power management for the board design, including specific components and configurations.
2026-08-16 Update JOURNAL.md with schematic and component details
    Documented changes to the power schematic and component choices for the robot project, including the switch to STM32H743ZIT6 MCU and the decision to use VL53L1X module instead of a 2D lidar. Added notes on wiring, current sensing with INA226, and omitted onboard battery charging for safety.
2026-08-20 Create POWER
2026-08-20 Update JOURNAL.md with power system design details
    Document research and design progress for power management system, including buck converter selection and preliminary PCB routing.
2026-08-21 Routing 1
    Completed all footprint and part sourcing. Completed half of the routing.
    [Boostconverter.kicad_pcb, Boostconverter.kicad_sch]
2026-08-21 Update JOURNAL.md with power board progress
    Documented progress on breakout board for power, including part sourcing challenges and PCB layout considerations.
2026-08-22 Update JOURNAL.md with PCB routing progress
    Documented progress on PCB routing and challenges faced with component placements. Included references and images for clarity.
2026-08-23 Update JOURNAL.md with PCB design progress
    Documented progress on breakout board and anchor PCB design, including routing details and grounding techniques.
2026-08-24 Update JOURNAL with progress on anchor PCB design
    Continued work on anchor PCB, focusing on decoupling capacitors for the DW3220 and power system for NRF52840. Documented challenges with component placement and crystal requirements.
2026-08-24 Revise journal entry for 8/23 on PCB work
    Updated journal entry for 8/23 detailing progress on the anchor PCB, challenges with decoupling capacitors, and design considerations for the nRF52840 power system.
2026-08-25 Update JOURNAL.md with recent PCB design notes
    Documented recent progress on PCB design, including component additions and sourcing challenges.
2026-08-26 Update JOURNAL.md with PCB research details
    Documented research on PCB manufacturing and RF performance considerations, including stackup effects and material choices.
2026-08-27 Document PCB research and mainboard design changes
    Updated journal with research on PCB design and changes made to the mainboard components.
2026-08-29 Update journal with entries for 8/27 and 8/29
    Merged journal entries for 8/27 and 8/29, detailing research on ESD protection and changes to components. Discussed time spent on PCB design and preliminary wiring.
2026-09-03 Update JOURNAL with STM32 power logic details
    Document progress on STM32 power and boot logic, including resistor changes and schematic updates.
2026-09-04 Update JOURNAL.md with routing details
    Documented preliminary routing for motor driver and dw3220, including challenges with pin assignments and timer usage.
2026-09-05 Update JOURNAL.md with motor research and decisions
    Documented research on motor selection and component choices for the mainboard, including the decision to use a BLDC motor and specific ESC components.
2026-09-14 Document design choices for STM32 and motor driver
    Added details about the use of two boards and the integration of the amt102 for movement correction. Explained the design logic and components involved in the project.
2026-09-15 Update JOURNAL.md with recent project developments
    Documented progress on stm32g0 board schematic and PCB routing challenges.
2026-10-04 commit 1 commit 1 10/03/2026
    [BMI270.kicad_sch, DW3220.kicad_sch, ESC.kicad_sch, MCT8316Z.kicad_sch, POWER_CONNECTOR.kicad_sch, Power_connector_g0.kicad_sch, autobot_mainboard.kicad_pcb, autobot_mainboard.kicad_sch]
2026-10-04 driver board schematic
    [BMI270.kicad_sch, DW3220.kicad_sch, ESC.kicad_sch, autobot_mainboard.kicad_pcb]
2026-10-04 10/3 final
    [ESC.kicad_sch, autobot_mainboard.kicad_pcb]
2026-10-04 Add journal entries for schematic and ESC updates
    Updated journal entries with progress on schematic and PCB design, including a switch to a sensorless ESC and associated images.
2026-10-04 new stm32 footprint
    [ESC.kicad_sch]
2026-10-04 almost done
    [ESC.kicad_sch, ESD_PROTECTION.kicad_sch, Power_connector_g0.kicad_sch, autobot_mainboard.kicad_pcb, autobot_mainboard.kicad_sch]
2026-10-04 driver board completed. Prelim, polish later
    [autobot_mainboard.kicad_pcb]
2026-10-10 add mosfets
    [AMT102.kicad_sch, BMI270.kicad_sch, DW3220.kicad_sch, ESC.kicad_sch, autobot_mainboard.kicad_pcb, autobot_mainboard.kicad_sch]
2026-10-10 change tvs
    [AMT102.kicad_sch, ESC.kicad_sch, ESD_PROTECTION.kicad_sch, autobot_mainboard.kicad_pcb]
2026-10-10 add tvs1400 with with ass routing
    [autobot_mainboard.kicad_pcb]
2026-10-10 change tvs1400 to another tvs with higher clamping voltage. fix footprints and add nreset
    [BMI270.kicad_sch, DW3220.kicad_sch, ESC.kicad_sch, ESD_PROTECTION.kicad_sch]
2026-10-10 add reset button to anchor, polish later
    [Anchor.kicad_pcb, Anchor.kicad_sch]
2026-10-10 functionally finished driver board
    [ESC.kicad_sch, STM32H743.kicad_sch, autobot_mainboard.kicad_pcb]
2026-10-10 driver done, unpolished
    [autobot_mainboard.kicad_pcb]
2026-10-10 edit boost converter, added gnd planes, polish later
    [Boostconverter.kicad_pcb, autobot_mainboard.kicad_pcb]
2026-10-11 port dw3220 routing to mainboard; copy shit
    [AMT102.kicad_sch, autobot_mainboard.kicad_pcb]
2026-10-11 Update JOURNAL.md with motor driver board details
    Documented progress on motor driver board and anchor PCB design. Included images and notes on grounding and component choices.
2026-10-11 buck converter prelim route
2026-10-12 Update JOURNAL.md with recent routing progress
    Documented progress on routing for bmi270 and power considerations for the driver board. Added images for reference.
2026-10-12 reminder to fix power
2026-10-24 changed power plane, do gnd stitching soon
2026-10-24 power zone
2026-10-24 Update JOURNAL.md with recent progress notes
    Documented progress on routing and configuration of sensors and driver board. Included time spent on tasks.
2026-10-25 resize driver board to 60x55 mm^2, spread out bldc motor out pads
